rafagenova/arduino-equivalent-board/!Released Files/!!! IMPORTANT !!! Release Document for Altium Designer.txt

Follow this procedure before releasing files. Confirm every action with your initials and date.
IF ANY CHANGES NEEDS TO BE DONE, START THE PROCEDURE FROM BEGINNING!

The procedure needs to be executed in order as defined here. Start from number 1
--------------------------------------------------------------------------------

1) Right Click on the project -> Compile PCB project
I confirm, the project compiles with no errors: 
RF [12-NOV-2020]

2) Run Design -> Update PCB Document
I confirm, there are no differences between Schematic and PCB: 
RF [12-NOV-2020]

3) Impedance
I confirm, I have updated and check track width/gap to match required impedance (e.g 55 OHMs): 
NA

4) Run Tools -> Polygon Pours -> Rebuild All
I confirm, all polygons have been repoured: 
RF [12-NOV-2020]

5) Run Tools -> Design Rule Check -> Run Design Rule Check
I confirm, I have checked Design Rule Output File:
RF [12-NOV-2020]

6) Gerber check
I confirm, I have copied and visually checked gerber files placed in \PCB Manufacturing\Gerber Output\
RF [12-NOV-2020]

7) Other files
I confirm, I have copied and checked files placed in subdirectories:
RF [12-NOV-2020]
