rafagenova/arduino-equivalent-board/!Released Files/Step 2 - Board Assembly/Variant 1 - 28Pins V1I1 - 5V FIXED/BOM Purchasing - 28Pins V1I1 - FIXED 5V.xlsx

Sheet: Part List Report
 | Component list |  |  | 28Pins BOM Purchasing for Variant [FIXED 5V] of Project [28Pins_Project_V1I1.PrjPcb] (PCB Document : 28Pins_PCB.PcbDoc)
 | Source Data From: | 28Pins_Project_V1I1.PrjPcb |  |  | Contact: |  |  |  | Generated by:
 | Project: | 28Pins_Project_V1I1.PrjPcb
 | Variant: | FIXED 5V |  |  |  |  |  |  | FEDEVEL
 | Report Date: | 13/11/2020 | 12:58 |  |  |  |  |  | http://www.fedevel.com
 | Print Date: | 2020-11-13 | 12:58:43
# | Category | Manufacturer 1 | Manufacturer Part Number 1 | Case/Package | Description | Quantity | Supplier 1 | Supplier Part Number 1 | Supplier Order Qty 1 | Supplier Stock 1 | Supplier Unit Price 1 | Supplier Subtotal 1 | Supplier Currency 1
1 | Aluminum Electrolytic Capacitors | Panasonic | EEE-1AA101WR | Radial | Cap Aluminum 100uF 10V 20% (5 X 5.4mm) SMD 50mA 1000 hr 85°C T/R | 2 | TTI | EEE-1AA101WR | 2000 | 171000 | 0.06 | 110.00 | USD
2 | Ceramic Capacitors | TDK | C2012X5R1C106K085AC | 805 | TDK - C2012X5R1C106K085AC - SMD Multilayer Ceramic Capacitor, 10 µF, 16 V, 0805 [2012 Metric], ± 10%, X5R, C Series TDK | 7 | Digi-Key | 445-7644-1-ND | 7000 | 1270360 | 0.06 | 407.33 | USD
3 | Ceramic Capacitors | TDK | C2012X7R1H104K085AA | 805 | TDK - C2012X7R1H104K085AA - SMD Multilayer Ceramic Capacitor, 0.1 µF, 50 V, 0805 [2012 Metric], ± 10%, X7R, C Series | 19 | Digi-Key | 445-7534-1-ND | 19000 | 411549 | 0.03 | 538.27 | USD
4 | Ceramic Capacitors | TDK | C2012X5R1E105K125AA | 805 | TDK - C2012X5R1E105K125AA - SMD Multilayer Ceramic Capacitor, 1 µF, 25 V, 0805 [2012 Metric], ± 10%, X5R, C Series | 1 | Digi-Key | 445-1419-1-ND | 1000 | 1716 | 0.05 | 48.58 | USD
5 | Ceramic Capacitors | KEMET | C0805C180J5GACTU | 805 | CAP CER 18PF 50V C0G/NP0 0805 | 4 | Digi-Key | 399-1112-1-ND | 4000 | 86095 | 0.02 | 94.44 | USD
6 | Uncategorized | Osram Opto | LGL29K-F2J1-24-Z | 603 | LED Uni-Color Green 572nm Automotive 2-Pin Chip 0603(1608Metric) T/R | 1 | NAC Semi | LGL29K-F2J1-24-Z |  | 20000 |  |  | USD
7 | Uncategorized | Osram Opto | LOL29K-H2K1-24 | 1608 | LED Uni-Color Orange 610nm 2-Pin Case 0603 T/R | 3 | Mouser | 720-LOL29KH2K124Z | 3000 | 16953 | 0.11 | 339.00 | USD
8 | Schottky Diodes | ON Semiconductor / Fairchild | BAT54HT1G |  | Small Signal Schottky Diode, Single, 30 V, 200 mA, 800 mV, 600 mA, 150 C ;RoHS Compliant: Yes | 2 | Digi-Key | BAT54HT1GOSCT-ND | 2000 | 244230 | 0.04 | 82.80 | USD
9 | Ferrite Beads and Chips | TDK | MPZ2012S601AT000 | 805 | FERRITE BEAD 600 OHM 0805 1LN | 3 | Digi-Key | 445-2206-1-ND | 3000 | 197637 | 0.03 | 87.84 | USD
10 | Headers and Wire Housings | Harwin | M20-7820842 | SIL | 2.54mm (0.1") Pitch SIL Vertical PC Tail Socket Assembly, selective gold + tin, 8 contacts | 2 | Digi-Key | 952-1823-ND | 2000 | 859 | 0.65 | 1292.80 | USD
11 | Headers and Wire Housings | Harwin | M20-7820646 | SIL | 06-WAY SIL VERT SOCKET L/FREE | 1 | Digi-Key | 952-1809-ND | 1000 | 2084 | 0.56 | 558.40 | USD
12 | Headers and Wire Housings | Harwin | M20-7821046 | SIL | HARWIN - M20-7821046 - Board-To-Board Connector, M20 Series, Through Hole, Receptacle, 10, 2.54 mm, Tin Plated Contacts | 1 | Digi-Key | 952-1847-ND | 1000 | 0 | 0.63 | 625.60 | USD
13 | Headers and Wire Housings | Amphenol ICC / FCI | 67997-106HLF |  | CONN HEADER 6POS .100 STR 30AU | 2 | Digi-Key | 609-3393-ND | 2000 | 1303 | 0.99 | 1976.70 | USD
14 | USB Connectors | AMPHENOL ICC (FCI) | 10118193-0001LF |  | CONN USB MICRO B RECPT SMT R/A | 1 | Digi-Key | 609-4616-1-ND | 1000 | 0 | 0.26 | 257.88 | USD
15 | Headers and Wire Housings | Amphenol ICC | 68000-103HLF |  | Conn Unshrouded Header HDR 3 POS 2.54mm Solder ST Thru-Hole Bulk | 1 | Digi-Key | 609-3461-ND | 1000 | 5274 | 0.14 | 139.30 | USD
16 | Headers and Wire Housings | Amphenol FCI | 68001-204HLF |  | CONN HEADER VERT 4POS 2.54MM | 1 | Digi-Key | 609-3402-ND | 1000 | 2472 | 0.18 | 178.68 | USD
17 | Fixed Inductors | KEMET | L1210R2R2MDWIT | 1210 | FIXED IND 2.2UH 2A 80 MOHM SMD | 1 | TTI | L1210R2R2MDWIT | 1000 | 14000 | 0.18 | 183.00 | USD
18 | Connectors | Sullins | QPC02SXGN-RC | 100 | CONN JUMPER SHORTING .100" GOLD | 2 | Digi-Key | S9337-ND | 2000 | 1052956 | 0.03 | 52.92 | USD
19 | Chip SMD Resistors | Yageo | RC0805FR-07100KL | 805 | YAGEO RC0805FR-07100KL RES, THICK FILM, 100K, 1%, 0.125W, 0805, REEL | 1 | Digi-Key | 311-100KCRCT-ND | 1000 | 2714272 | 0.01 | 6.65 | USD
20 | Chip SMD Resistors | Yageo | RC0805FR-07560RL | 805 | Surface Mount Thick Film Resistor, RC Series, 560 ohm, 125 mW, - 1%, 150 V, 0805 [2012 Metric] | 5 | Digi-Key | 311-560CRCT-ND | 5000 | 0 | 0.01 | 28.85 | USD
21 | Chip SMD Resistors | Yageo | RC0805FR-0710KL | 805 | RES SMD 10K OHM 1% 1/8W 0805 | 6 | Digi-Key | 311-10.0KCRCT-ND | 6000 | 16724231 | 0.01 | 34.62 | USD
22 | Chip SMD Resistors | Yageo | RC0805FR-0722RL | 805 | RES SMD 22 OHM 1% 1/8W 0805 | 7 | Digi-Key | 311-22.0CRCT-ND | 7000 | 588085 | 0.01 | 40.39 | USD
23 | Chip SMD Resistors | Yageo | RC0805JR-070RL | 805 | Surface Mount Thick Film Resistor, RC Series, 125 mW, - 5%, 150 V, 0805 [2012 Metric] | 2 | Digi-Key | 311-0.0ARCT-ND | 2000 | 5204056 | 0.01 | 11.44 | USD
24 | Chip SMD Resistors | Yageo | RC0805FR-071ML | 805 | RES SMD 1M OHM 1% 1/8W 0805 | 2 | Digi-Key | 311-1.00MCRCT-ND | 2000 | 2559440 | 0.01 | 13.30 | USD
25 | Chip SMD Resistors | Yageo | RC0805FR-071KL | 805 | RESISTOR, 0805 1K 1%, FULL REEL; Product Range:YAGEO - RC Series; Resistance:1kohm; Power Rating:125mW; Resistance Tolerance:± 1%; Resistor Case Style:0805 [2012 Metric]; Resistor Element Material:Thick Film; Temperature Coefficient:± 250ppm/°C; Voltage Rating:150V; Packaging:Tape & Reel; MSL:-; SVHC:No SVHC (16-Dec-2013); External Depth:0.55mm; External Length / Height:2mm; External Width:1.25mm; No. of Pins:2; Operating Temperature Max:155°C; Operating Temperature Min:-55°C; Operating Temperature Range:-55°C to +155°C; Reel Quantity:5000; Resistor Mounting:SMD; Series:RC12H; Temperature Coef | 3 | Digi-Key | 311-1.00KCRCT-ND | 3000 | 15540939 | 0.01 | 17.31 | USD
26 | Connectors | 3M | 7010501790 |  | CONN IC DIP SOCKET 28POS TIN | 1 | Digi-Key | 3M5480-ND | 1000 | 3382 | 0.44 | 435.04 | USD
27 | Pushbutton Switches | TE Connectivity | FSM4JH |  | SWITCH TACTILE SPST-NO 0.05A 24V | 2 | Digi-Key | 450-1650-ND | 2000 | 97566 | 0.06 | 125.30 | USD
28 | Microcontrollers | Microchip / Atmel | ATMEGA328P-PU | PDIP | ATMEGA328P-PU; 8 bit Microcontroller AVR 20MHz 1; 32kb Flash; 2kb RAM; I2C SPI 2 | 1 | Digi-Key | ATMEGA328P-PU-ND | 1000 | 6893 | 1.73 | 1730.00 | USD
29 | Microcontrollers | Microchip | ATMEGA16U2-AU | A | MICROCHIP - ATMEGA16U2-AU - MCU, 8BIT, MEGAAVR, 16MHZ, TQFP-32 | 1 | Digi-Key | ATMEGA16U2-AU-ND | 1000 | 3181 | 2.04 | 2040.00 | USD
30 | Voltage Regulators - Linear | Texas Instruments | TL1963A-33DCQR | SOT-223 | IC REG LINEAR 3.3V 1.5A SOT223-6 | 1 | Digi-Key | 296-24534-1-ND | 1000 | 2622 | 1.40 | 1404.48 | USD
31 | Logic Gates | Texas Instruments | SN74AHC1G09DBVR | SOT-23 | TEXAS INSTRUMENTS - SN74AHC1G09DBVR - AND Gate, 74AHC1G09, 2 Input, 2 V to 5.5 V, SOT-23-5 | 4 | Digi-Key | 296-29202-1-ND | 4000 | 20291 | 0.07 | 276.00 | USD
32 | Crystals | Abracon | ABM7-16.000MHZ-D2Y-T | CSMD | CRYSTAL 16.0000MHZ 18PF SMD | 2 | Digi-Key | 535-9840-1-ND | 2000 | 57628 | 0.60 | 1209.60 | USD
33 | Varistors | Bourns | CG0603MLC-05E | 603 | VARISTOR 0603 | 2 | Digi-Key | CG0603MLC-05ECT-ND | 2000 | 91563 | 0.10 | 208.00 | USD
 |  |  |  |  |  | 94 |  |  | 93000 |  |  | 14554.52
Approved |  |  |  | Notes
 |  |  |  |  |  | 1000 | pcs: | Total |  | 14554.52 |  | USD
 |  |  |  |  |  |  |  | Price for 1pcs |  | 14.55 |  | USD

Sheet: Project Information
Project Full Path | C:\Users\rafae\OneDrive\Área de Trabalho\Férias 2020\PCB Design\Design Files\V1I1\28Pins_Project_V1I1\28Pins_Project_V1I1.PrjPcb
Project Filename | 28Pins_Project_V1I1.PrjPcb
Variant Name | FIXED 5V
Data-Source Filename | 28Pins_Project_V1I1.PrjPcb
Data-Source Full Path | C:\Users\rafae\OneDrive\Área de Trabalho\Férias 2020\PCB Design\Design Files\V1I1\28Pins_Project_V1I1\28Pins_Project_V1I1.PrjPcb
Title | 28Pins BOM Purchasing for Variant [FIXED 5V] of Project [28Pins_Project_V1I1.PrjPcb] (PCB Document : 28Pins_PCB.PcbDoc)
Total Quantity | 94
Report Time | 12:58
Report Date | 13/11/2020
Report Date & Tine | 13/11/2020 12:58
Output Name | 28Pins BOM Purchasing
Output Type | BOM_PartType
Output Generator Name | BOM
Output Generator Description | Bill of Materials
