rafagenova/arduino-equivalent-board/!Released Files/Step 2 - Board Assembly/Variant 1 - 28Pins V1I1 - 5V FIXED/BOM Reference - 28Pins V1I1 - FIXED 5V.xlsx

Sheet: Part List Report
 | Component reference list |  |  | 28Pins
 |  | Source Data From: | 28Pins_Project_V1I1.PrjPcb |  | Contact: |  | Generated by:
 |  | Project: | 28Pins_Project_V1I1.PrjPcb
 |  | Variant: | FIXED 5V |  |  |  | FEDEVEL
 | Report Date: | 13/11/2020 | 14:43 |  |  |  | http://www.fedevel.com
 | Print Date: | 2020-11-13 | 14:43:36
# | Designator | Comment | Description | Manufacturer 1 | Manufacturer Part Number 1 | Case/Package | Supplier 1 | Supplier Part Number 1
1 | R1 | 100k | YAGEO RC0805FR-07100KL RES, THICK FILM, 100K, 1%, 0.125W, 0805, REEL | Yageo | RC0805FR-07100KL | 805 | Digi-Key | 311-100KCRCT-ND
2 | R2, R3, R15, R17, R22 | 560R | Surface Mount Thick Film Resistor, RC Series, 560 ohm, 125 mW, - 1%, 150 V, 0805 [2012 Metric] | Yageo | RC0805FR-07560RL | 805 | Digi-Key | 311-560CRCT-ND
3 | R4, R14, R18, R19, R20, R21 | 10k | RES SMD 10K OHM 1% 1/8W 0805 | Yageo | RC0805FR-0710KL | 805 | Digi-Key | 311-10.0KCRCT-ND
4 | R5, R6, R7, R13, R23, R24, R25 | 22R | RES SMD 22 OHM 1% 1/8W 0805 | Yageo | RC0805FR-0722RL | 805 | Digi-Key | 311-22.0CRCT-ND
5 | R8, R27 | 0R | Surface Mount Thick Film Resistor, RC Series, 125 mW, - 5%, 150 V, 0805 [2012 Metric] | Yageo | RC0805JR-070RL | 805 | Digi-Key | 311-0.0ARCT-ND
6 | R9, R16 | 1M | RES SMD 1M OHM 1% 1/8W 0805 | Yageo | RC0805FR-071ML | 805 | Digi-Key | 311-1.00MCRCT-ND
7 | R10, R11, R12 | 1k | RESISTOR, 0805 1K 1%, FULL REEL; Product Range:YAGEO - RC Series; Resistance:1kohm; Power Rating:125mW; Resistance Tolerance:± 1%; Resistor Case Style:0805 [2012 Metric]; Resistor Element Material:Thick Film; Temperature Coefficient:± 250ppm/°C; Voltage Rating:150V; Packaging:Tape & Reel; MSL:-; SVHC:No SVHC (16-Dec-2013); External Depth:0.55mm; External Length / Height:2mm; External Width:1.25mm; No. of Pins:2; Operating Temperature Max:155°C; Operating Temperature Min:-55°C; Operating Temperature Range:-55°C to +155°C; Reel Quantity:5000; Resistor Mounting:SMD; Series:RC12H; Temperature Coef | Yageo | RC0805FR-071KL | 805 | Digi-Key | 311-1.00KCRCT-ND
8 | U3 | TL1963A-33DCQR | IC REG LINEAR 3.3V 1.5A SOT223-6 | Texas Instruments | TL1963A-33DCQR | SOT-223 | Digi-Key | 296-24534-1-ND
9 | U4, U5, U6, U7 | SN74AHC1G09DBVR | TEXAS INSTRUMENTS - SN74AHC1G09DBVR - AND Gate, 74AHC1G09, 2 Input, 2 V to 5.5 V, SOT-23-5 | Texas Instruments | SN74AHC1G09DBVR | SOT-23 | Digi-Key | 296-29202-1-ND
10 | SW1, SW2 | 1825910-6 | SWITCH TACTILE SPST-NO 0.05A 24V | TE Connectivity | FSM4JH |  | Digi-Key | 450-1650-ND
11 | C3, C12, C13, C19, C21, C22, C34 | 10u / 16V | TDK - C2012X5R1C106K085AC - SMD Multilayer Ceramic Capacitor, 10 µF, 16 V, 0805 [2012 Metric], ± 10%, X5R, C Series TDK | TDK | C2012X5R1C106K085AC | 805 | Digi-Key | 445-7644-1-ND
12 | C4, C5, C6, C8, C11, C14, C15, C16, C17, C20, C23, C24, C26, C28, C29, C30, C31, C32, C33 | 100n | TDK - C2012X7R1H104K085AA - SMD Multilayer Ceramic Capacitor, 0.1 µF, 50 V, 0805 [2012 Metric], ± 10%, X7R, C Series | TDK | C2012X7R1H104K085AA | 805 | Digi-Key | 445-7534-1-ND
13 | C7 | 1uF / 25V | TDK - C2012X5R1E105K125AA - SMD Multilayer Ceramic Capacitor, 1 µF, 25 V, 0805 [2012 Metric], ± 10%, X5R, C Series | TDK | C2012X5R1E105K125AA | 805 | Digi-Key | 445-1419-1-ND
14 | FB1, FB2, FB3 | MPZ2012S601AT000 | FERRITE BEAD 600 OHM 0805 1LN | TDK | MPZ2012S601AT000 | 805 | Digi-Key | 445-2206-1-ND
15 | LINK1, LINK2 | LINK | CONN JUMPER SHORTING .100" GOLD | Sullins | QPC02SXGN-RC | 100 | Digi-Key | S9337-ND
16 | C1, C2 | 100u / 10V | Cap Aluminum 100uF 10V 20% (5 X 5.4mm) SMD 50mA 1000 hr 85°C T/R | Panasonic | EEE-1AA101WR | Radial | TTI | EEE-1AA101WR
17 | D1 | Green | LED Uni-Color Green 572nm Automotive 2-Pin Chip 0603(1608Metric) T/R | Osram Opto | LGL29K-F2J1-24-Z | 603 | NAC Semi | LGL29K-F2J1-24-Z
18 | D2, D3, D4 | Orange | LED Uni-Color Orange 610nm 2-Pin Case 0603 T/R | Osram Opto | LOL29K-H2K1-24 | 1608 | Mouser | 720-LOL29KH2K124Z
19 | D5, D6 | BAT54HT1G | Small Signal Schottky Diode, Single, 30 V, 200 mA, 800 mV, 600 mA, 150 C ;RoHS Compliant: Yes | ON Semiconductor / Fairchild | BAT54HT1G |  | Digi-Key | BAT54HT1GOSCT-ND
20 | U1 | ATMEGA328P-PU | ATMEGA328P-PU; 8 bit Microcontroller AVR 20MHz 1; 32kb Flash; 2kb RAM; I2C SPI 2 | Microchip / Atmel | ATMEGA328P-PU | PDIP | Digi-Key | ATMEGA328P-PU-ND
21 | U2 | ATMEGA16U2-AU | MICROCHIP - ATMEGA16U2-AU - MCU, 8BIT, MEGAAVR, 16MHZ, TQFP-32 | Microchip / Atmel | ATMEGA16U2-AU | A | Digi-Key | ATMEGA16U2-AU-ND
22 | C9, C10, C25, C27 | 18p | CAP CER 18PF 50V C0G/NP0 0805 | KEMET | C0805C180J5GACTU | 805 | Digi-Key | 399-1112-1-ND
23 | L1 | 2u2 / 2A | FIXED IND 2.2UH 2A 80 MOHM SMD | KEMET | L1210R2R2MDWIT | 1210 | TTI | L1210R2R2MDWIT
24 | J1, J3 | HDR FEMALE 1x8 2.54mm | 2.54mm (0.1") Pitch SIL Vertical PC Tail Socket Assembly, selective gold + tin, 8 contacts | Harwin | M20-7820842 | SIL | Digi-Key | 952-1823-ND
25 | J2 | HDR FEMALE 1x6 2.54mm | 06-WAY SIL VERT SOCKET L/FREE | Harwin | M20-7820646 | SIL | Digi-Key | 952-1809-ND
26 | J4 | HDR FEMALE 1x10 2.54mm | HARWIN - M20-7821046 - Board-To-Board Connector, M20 Series, Through Hole, Receptacle, 10, 2.54 mm, Tin Plated Contacts | Harwin | M20-7821046 | SIL | Digi-Key | 952-1847-ND
27 | Z1, Z2 | CG0603MLC-05E | VARISTOR 0603 | Bourns | CG0603MLC-05E | 603 | Digi-Key | CG0603MLC-05ECT-ND
28 | J5, J6 | HDR 2x3 | CONN HEADER 6POS .100 STR 30AU | Amphenol ICC / FCI | 67997-106HLF |  | Digi-Key | 609-3393-ND
29 | J7 | 10118193-0001LF | CONN USB MICRO B RECPT SMT R/A | AMPHENOL ICC (FCI) | 10118193-0001LF |  | Digi-Key | 609-4616-1-ND
30 | JP1 | HDR 1x3 | Conn Unshrouded Header HDR 3 POS 2.54mm Solder ST Thru-Hole Bulk | Amphenol ICC | 68000-103HLF |  | Digi-Key | 609-3461-ND
31 | JP3 | HDR 1x4 | CONN HEADER VERT 4POS 2.54MM | Amphenol FCI | 68001-204HLF |  | Digi-Key | 609-3402-ND
32 | Y1, Y2 | ABM7-16.000MHZ-D2Y-T | CRYSTAL 16.0000MHZ 18PF SMD | Abracon | ABM7-16.000MHZ-D2Y-T | CSMD | Digi-Key | 535-9840-1-ND
33 | SCKT FOR U1 | 28-DIP Socket | CONN IC DIP SOCKET 28POS TIN | 3M | 7010501790 |  | Digi-Key | 3M5480-ND
Approved |  |  |  | Notes

Sheet: Project Information
Project Full Path | C:\Users\rafae\OneDrive\Área de Trabalho\Férias 2020\PCB Design\Design Files\V1I1\28Pins_Project_V1I1\28Pins_Project_V1I1.PrjPcb
Project Filename | 28Pins_Project_V1I1.PrjPcb
Variant Name | FIXED 5V
Data-Source Filename | 28Pins_Project_V1I1.PrjPcb
Data-Source Full Path | C:\Users\rafae\OneDrive\Área de Trabalho\Férias 2020\PCB Design\Design Files\V1I1\28Pins_Project_V1I1\28Pins_Project_V1I1.PrjPcb
Title | 28Pins_Project_V1I1.PrjPcb
Total Quantity | 94
Report Time | 14:43
Report Date | 13/11/2020
Report Date & Tine | 13/11/2020 14:43
Output Name | 28Pins Component reference BOM
Output Type | BOM_PartType
Output Generator Name | BOM
Output Generator Description | Bill of Materials
