rafagenova/arduino-equivalent-board/Design Files/V1I1/28Pins_Project_V1I1/BOM Purchase FEDEVEL Live.xlsx

Sheet: Part List Report
 | Component list |  |  | Field=Title
 | Source Data From: | Field=DataSourceFileName |  |  | Contact: |  |  |  | Generated by:
 | Project: | Field=ProjectFileName
 | Variant: | Field=VariantName |  |  |  |  |  |  | FEDEVEL
 | Report Date: | Field=ReportDate | Field=ReportTime |  |  |  |  |  | http://www.fedevel.com
 | Print Date: | 2020-09-30 | 20:50:32
# | Column=Category | Column=Manufacturer 1 | Column=Manufacturer Part Number 1 | Column=Case/Package | Column=Description | Column=Quantity | Column=Supplier 1 | Column=Supplier Part Number 1 | Column=Supplier Order Qty 1 | Column=Supplier Stock 1 | Column=Supplier Unit Price 1 | Column=Supplier Subtotal 1 | Column=Supplier Currency 1
1
2
3
 |  |  |  |  |  | 0 |  |  | 0 |  |  | 0
Approved |  |  |  | Notes
 |  |  |  |  |  | Field=ProductionQuantity | pcs: | Total |  | 0 |  | Field=Currency
 |  |  |  |  |  |  |  | Price for 1pcs |  | #VALUE! |  | Field=Currency

Sheet: Project Information
Project Full Path | Field=ProjectFullPath
Project Filename | Field=ProjectFileName
Variant Name | Field=VariantName
Data-Source Filename | Field=DataSourceFileName
Data-Source Full Path | Field=DataSourceFullPath
Title | Field=Title
Total Quantity | Field=TotalQuantity
Report Time | Field=ReportTime
Report Date | Field=ReportDate
Report Date & Tine | Field=ReportDateTime
Output Name | Field=OutputName
Output Type | Field=OutputType
Output Generator Name | Field=GeneratorName
Output Generator Description | Field=GeneratorDescription
