rafagenova/arduino-equivalent-board/3d/HDR_1x3_White.stp

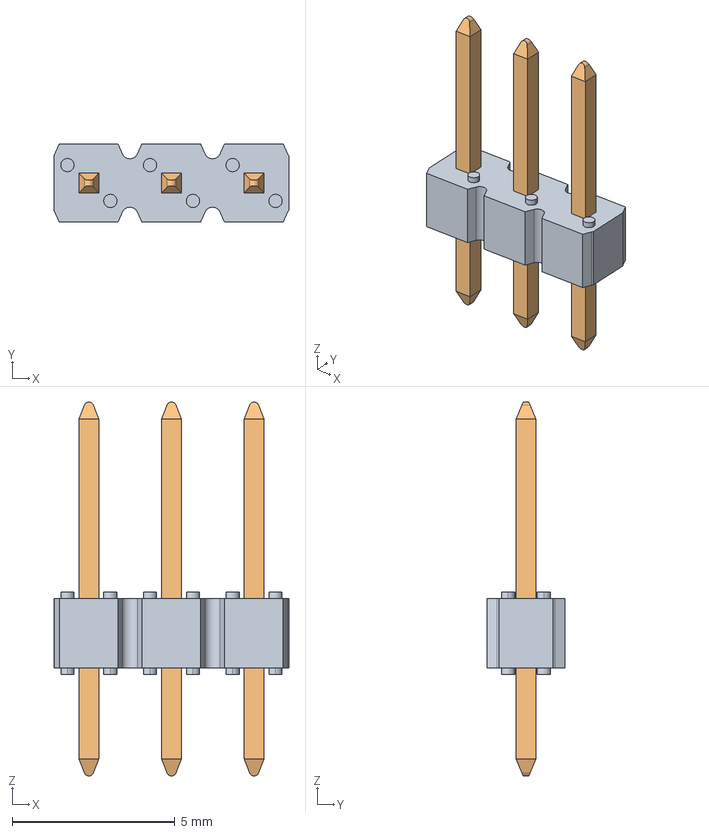
[picture p1: CAD file, 2022-08-11]
3d/HDR_1x3_White.stp
7.22 x 2.41 x 11.5 mm
77310_Y16 x 3
