rafagenova/arduino-equivalent-board/3d/User Library-LED SMD 0603 super red.step

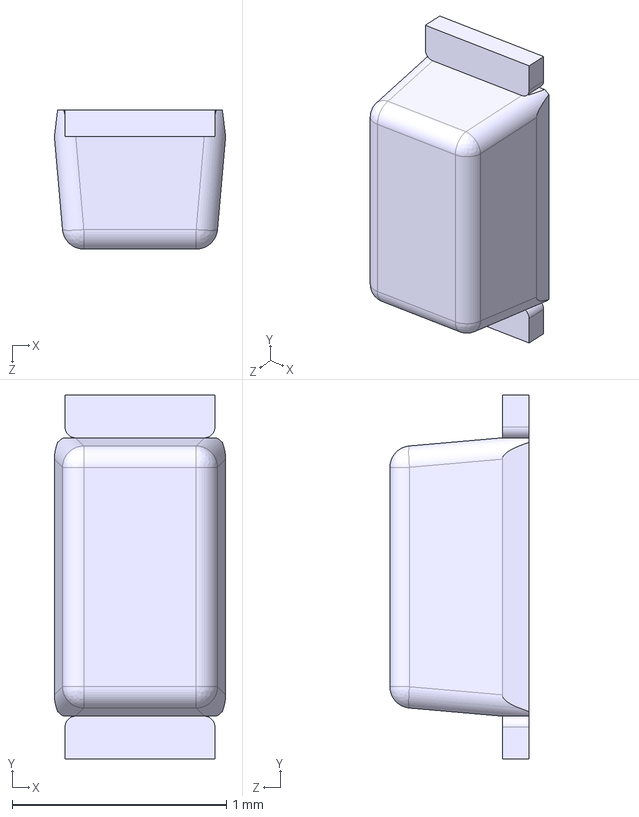
[picture p2: CAD file, 2022-08-11]
3d/User Library-LED SMD 0603 super red.step
0.8 x 1.70 x 0.65 mm
