rafagenova/arduino-equivalent-board/3d/User Library-TPS79333DBVR.step

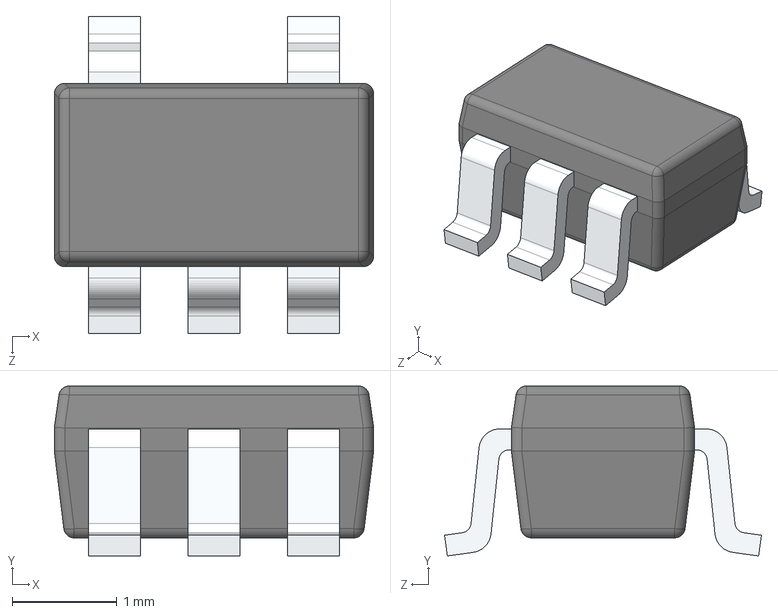
[picture p3: CAD file, 2022-08-11]
3d/User Library-TPS79333DBVR.step
3.05 x 1.62 x 3.03 mm
