rafagenova/arduino-equivalent-board/3d/User Library-28 pin dip.step

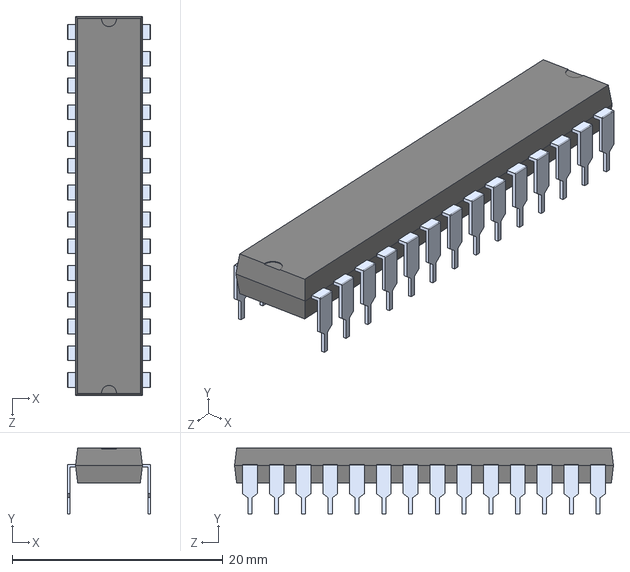
[picture p4: CAD file, 2022-08-11]
3d/User Library-28 pin dip.step
7.87 x 6.22 x 35.9 mm
