rafagenova/arduino-equivalent-board/3d/ABM7.STEP

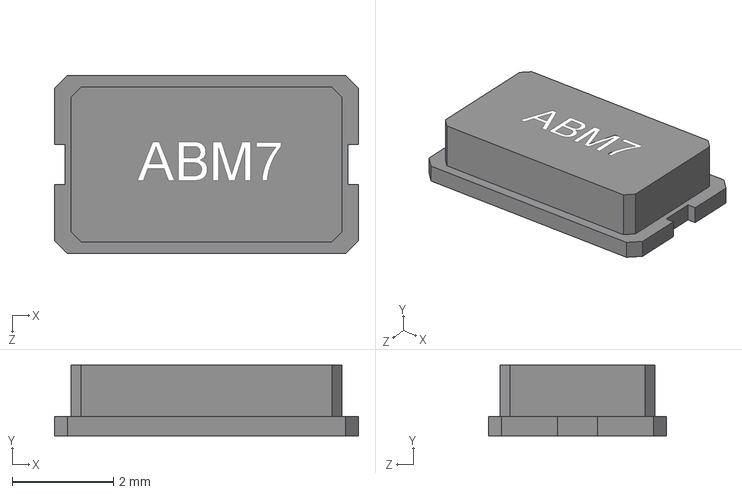
[picture p5: CAD file, 2022-08-11]
3d/ABM7.STEP
5.99 x 1.40 x 3.51 mm
