rafagenova/arduino-equivalent-board/3d/RESC2012X70N EIA 0805.step

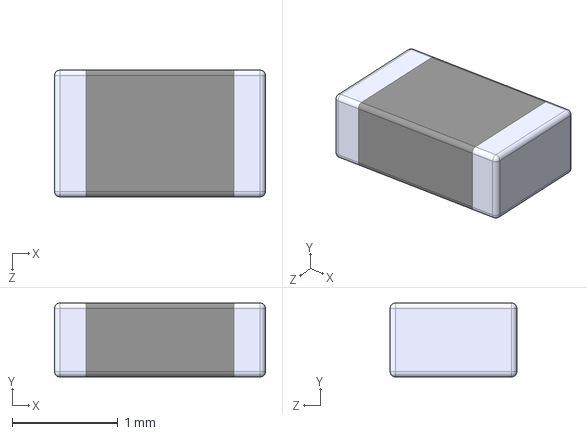
[picture p6: CAD file, 2022-08-11]
3d/RESC2012X70N EIA 0805.step
2.00 x 0.7 x 1.20 mm
