rafagenova/arduino-equivalent-board/3d/User Library-FSM4JLH(1825910-5).step

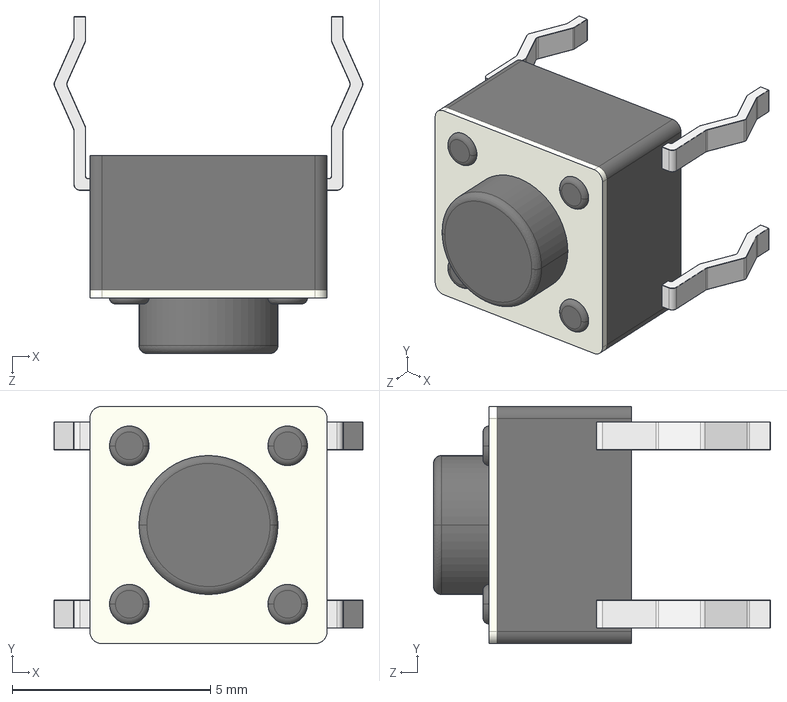
[picture p7: CAD file, 2022-08-11]
3d/User Library-FSM4JLH(1825910-5).step
7.80 x 5.99 x 8.51 mm
