rafagenova/arduino-equivalent-board/3d/User Library-TPS73701DCQ.step

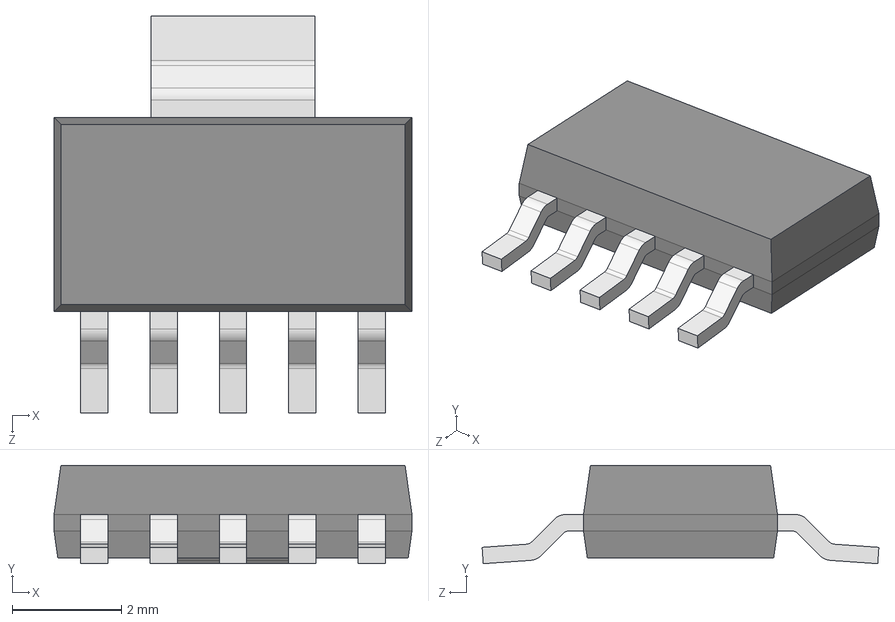
[picture p8: CAD file, 2022-08-11]
3d/User Library-TPS73701DCQ.step
6.55 x 1.80 x 7.26 mm
