rafagenova/arduino-equivalent-board/3d/User Library-SOD323.step

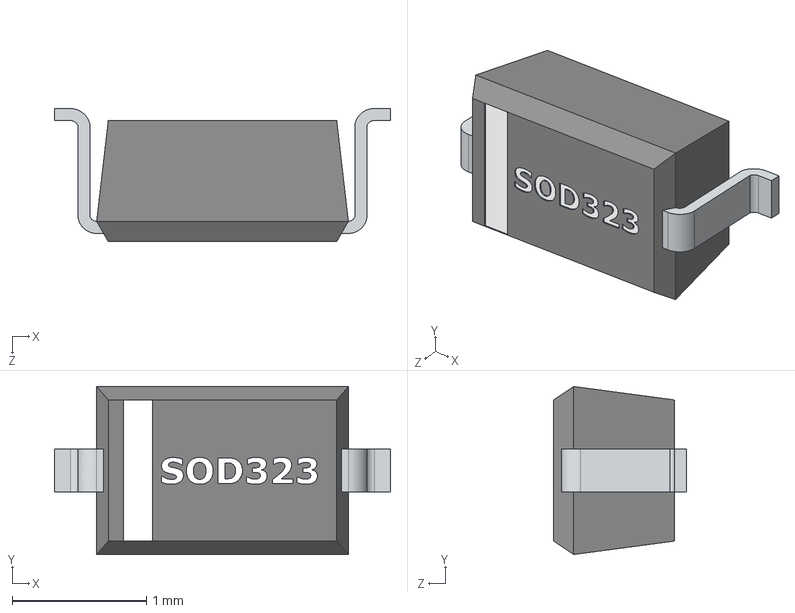
[picture p9: CAD file, 2022-08-11]
3d/User Library-SOD323.step
2.50 x 1.25 x 0.99 mm
