rafagenova/arduino-equivalent-board/3d/User Library-TQFP32-1.step

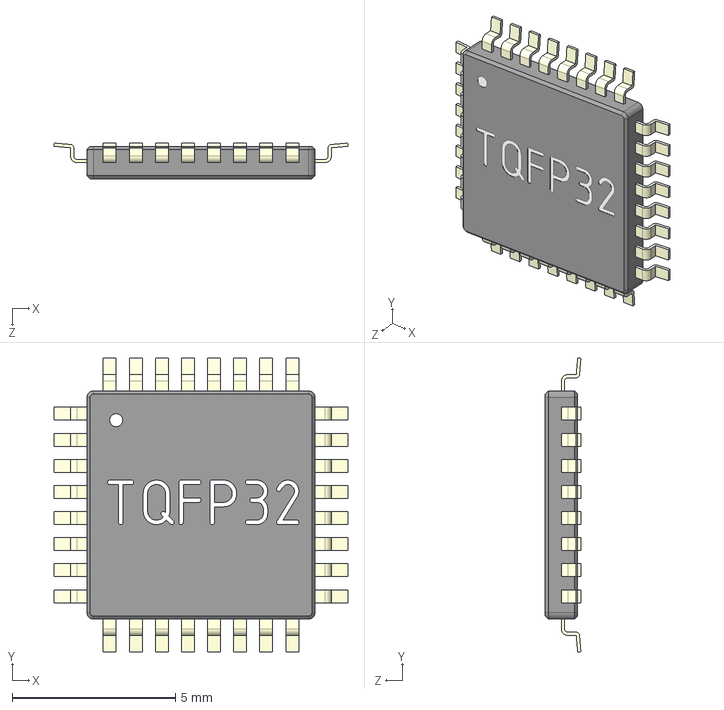
[picture p10: CAD file, 2022-08-11]
3d/User Library-TQFP32-1.step
9.02 x 9.02 x 1.10 mm
