rafagenova/arduino-equivalent-board/3d/HDR_1x4_White.stp

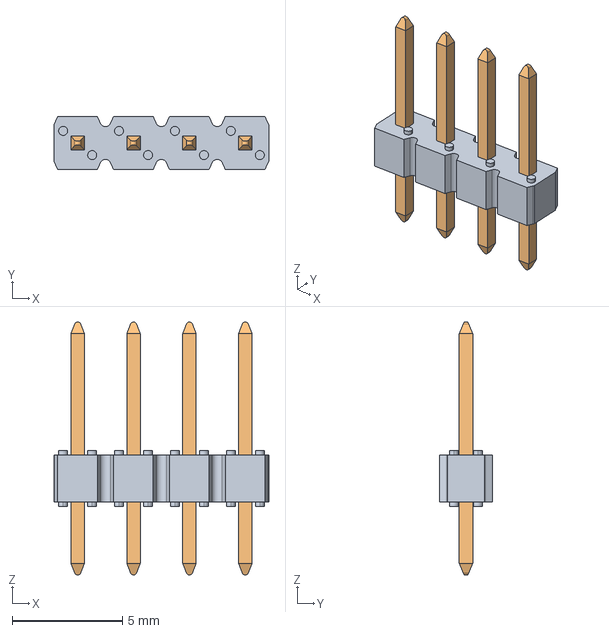
[picture p11: CAD file, 2022-08-11]
3d/HDR_1x4_White.stp
9.76 x 2.41 x 11.5 mm
