rafagenova/arduino-equivalent-board/3d/dil_socket.stp

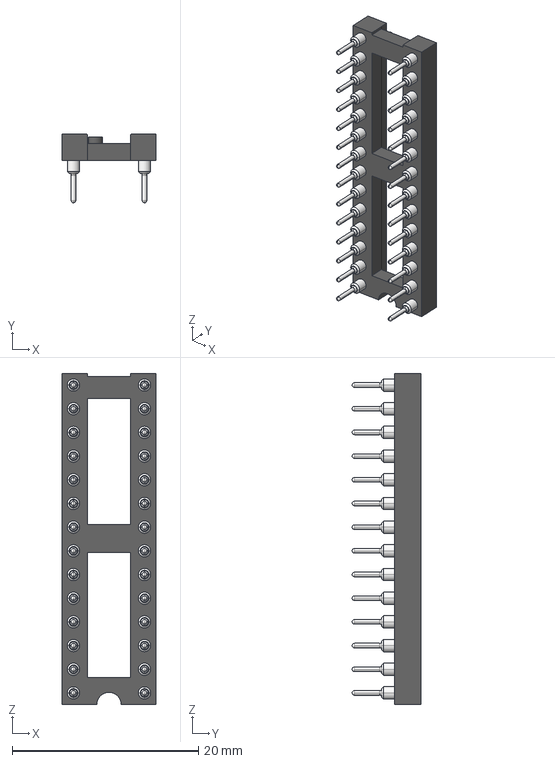
[picture p12: CAD file, 2022-08-11]
3d/dil_socket.stp
10.1 x 7.37 x 35.5 mm
