rafagenova/arduino-equivalent-board/3d/User Library-capacitor size C.step

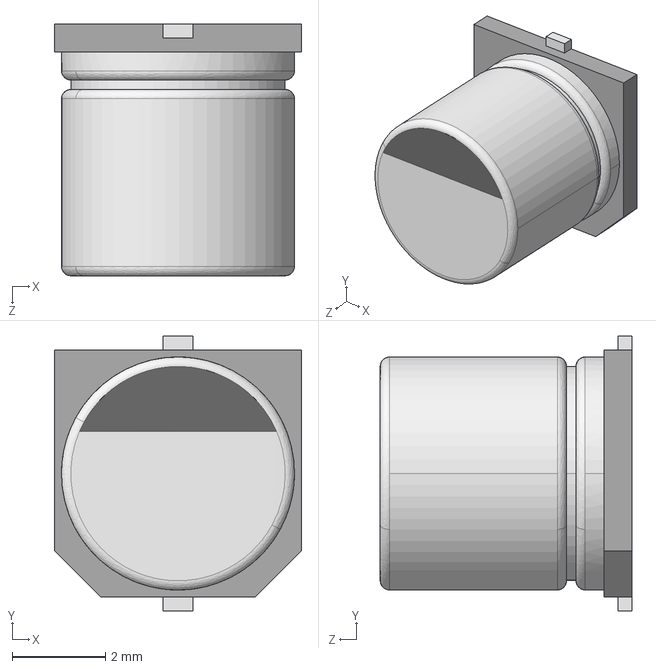
[picture p13: CAD file, 2022-08-11]
3d/User Library-capacitor size C.step
5.30 x 5.90 x 5.41 mm
