rafagenova/arduino-equivalent-board/3d/CAPC2012X95N EIA 0805.step

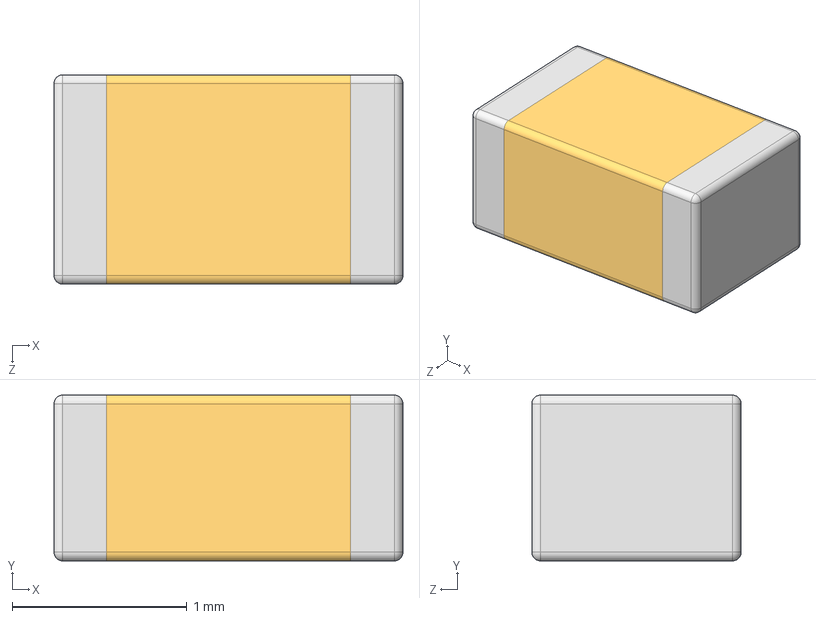
[picture p14: CAD file, 2022-08-11]
3d/CAPC2012X95N EIA 0805.step
2.00 x 0.95 x 1.20 mm
