rafagenova/arduino-equivalent-board/3d/R0603.step

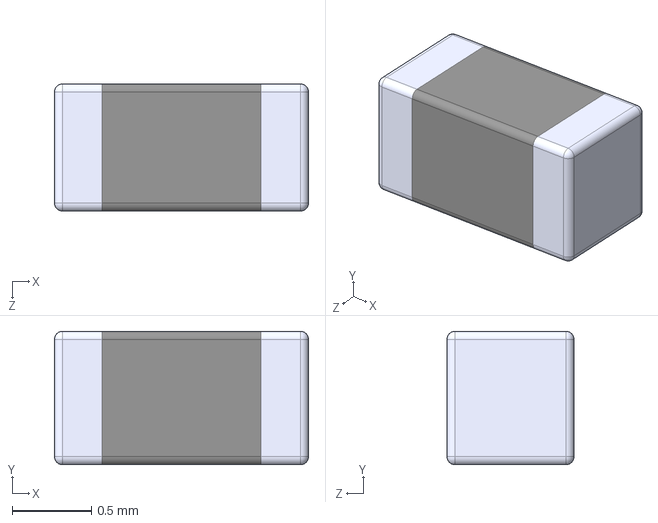
[picture p15: CAD file, 2022-08-11]
3d/R0603.step
1.60 x 0.84 x 0.8 mm
