rafagenova/arduino-equivalent-board/3d/m20-7820842_asm.stp

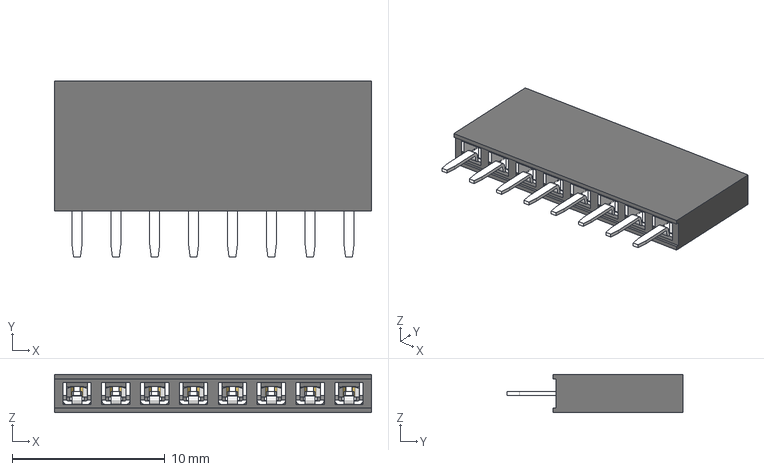
[picture p16: CAD file, 2022-08-11]
3d/m20-7820842_asm.stp
20.7 x 11.5 x 2.50 mm
M20-78208_MOULD
M20-782_CONTACT x 8
