rafagenova/arduino-equivalent-board/(list of files, cad)

Other CAD files:
3d/961204-6404-XX.stp
3d/961206-6404-XX.stp
