rafagenova/arduino-equivalent-board/!Released Files/Step 1 - PCB Manufacturing/NC Drill Output/28Pins Drill Drawing.PDF

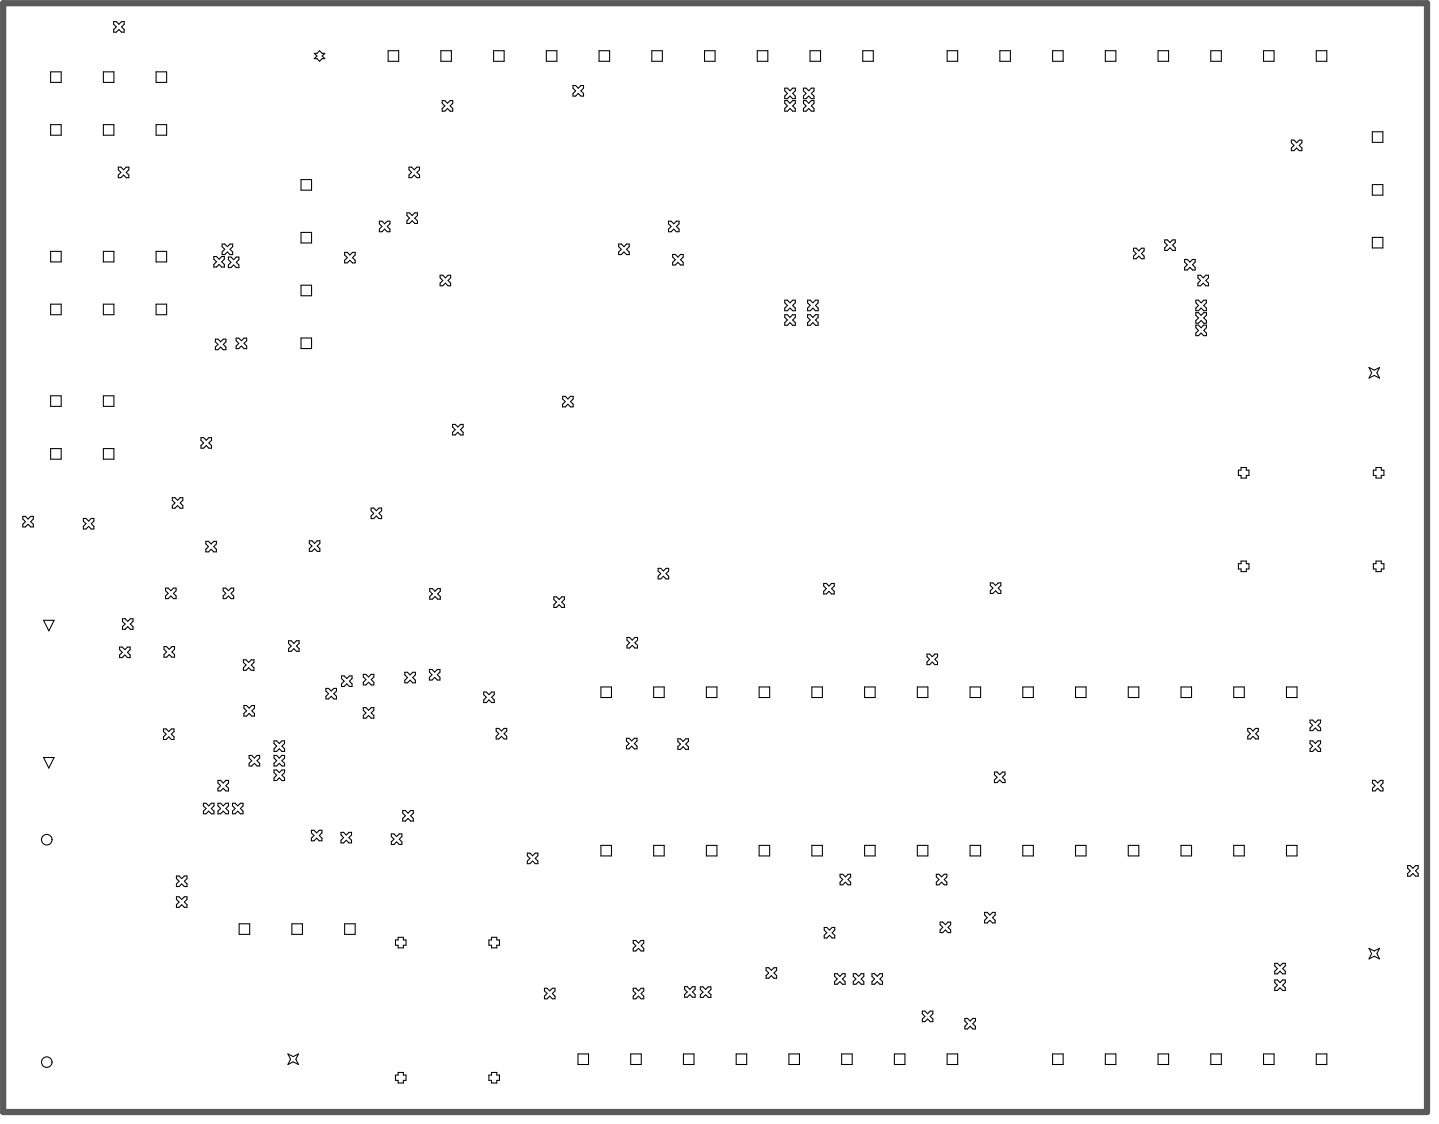
[picture p20: page 1]

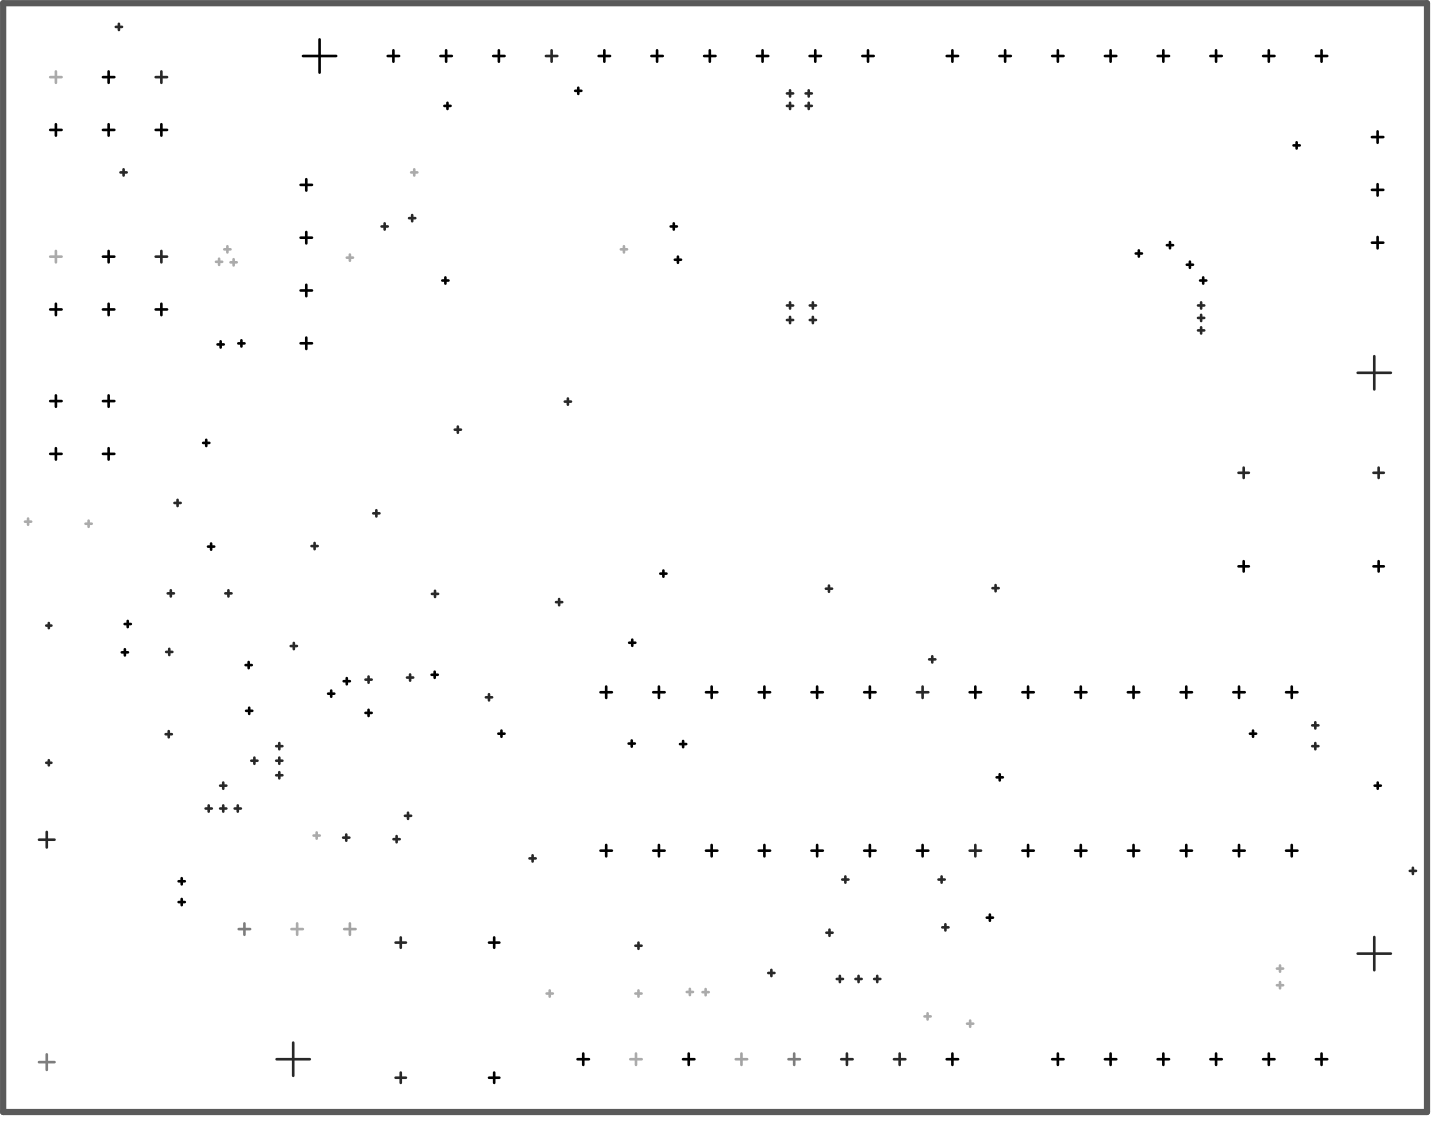
[picture p21: page 2]
