rafagenova/arduino-equivalent-board/!Released Files/Step 2 - Board Assembly/Variant 1 - 28Pins V1I1 - 5V FIXED/28Pins Assembly Drawing V1I1 - FIXED 5V.PDF

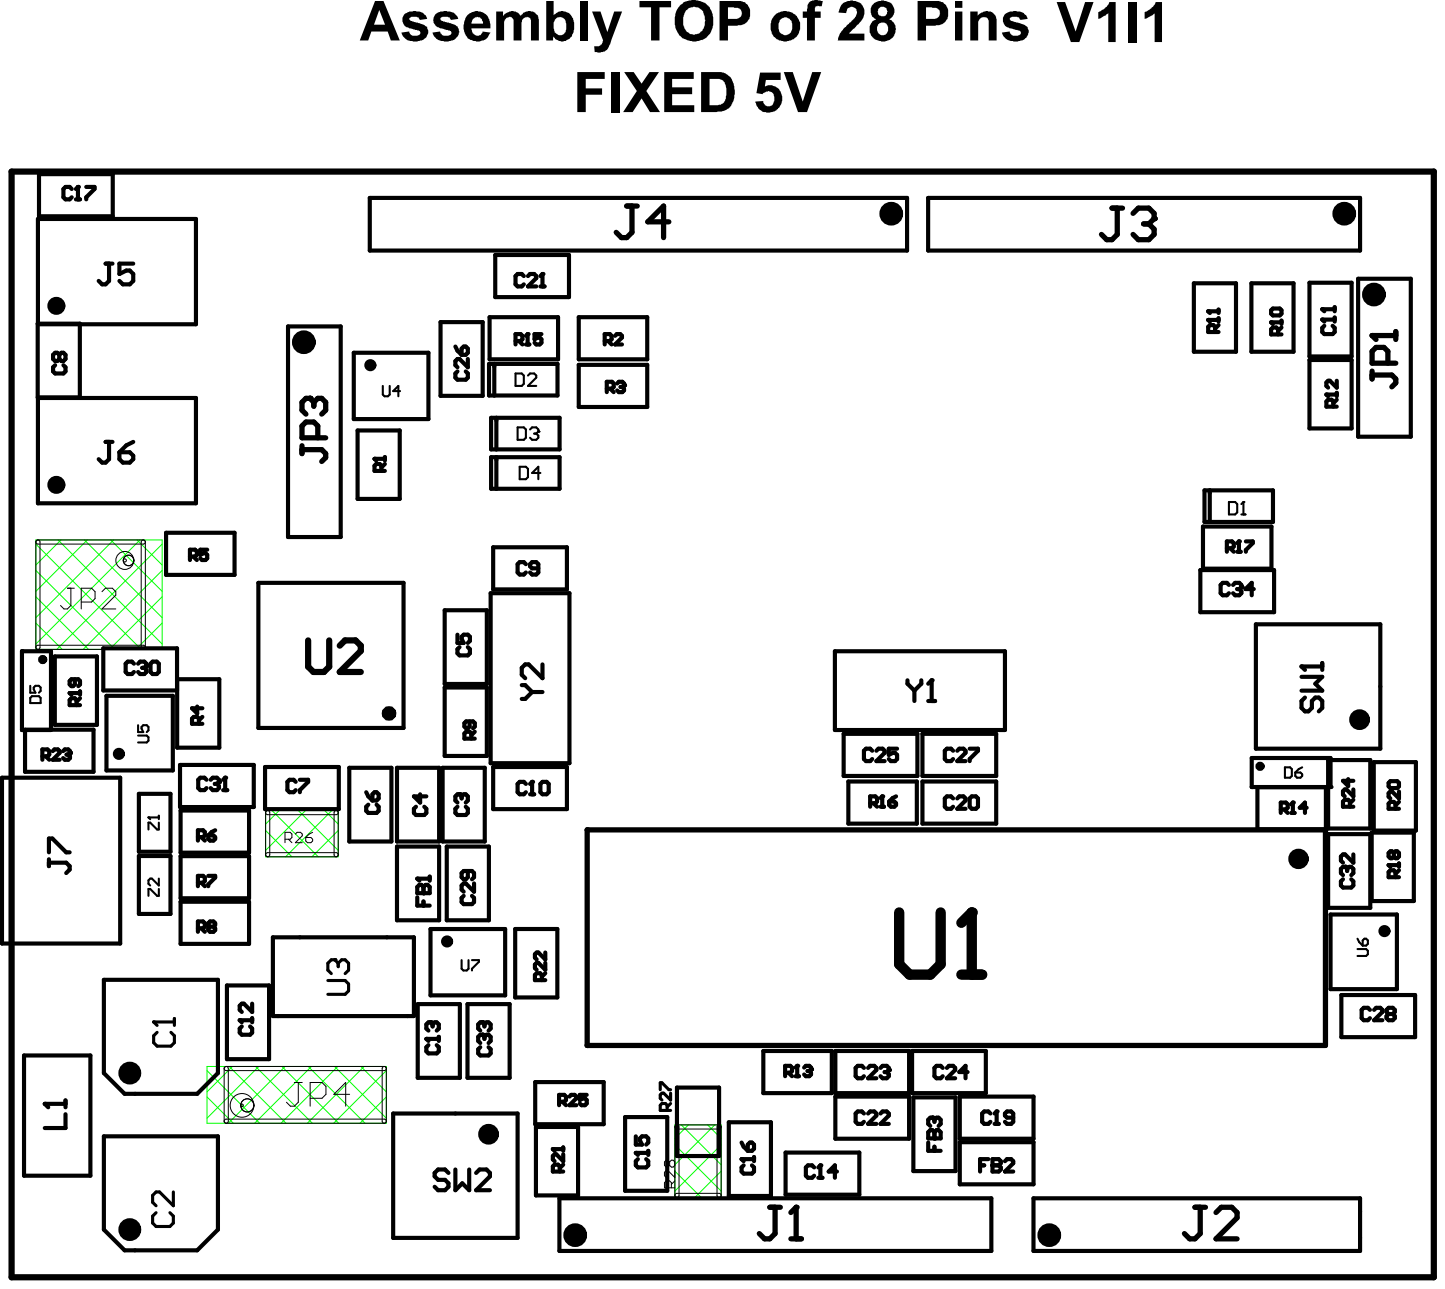
[picture p22: page 1]
