rafagenova/arduino-equivalent-board/!Released Files/Step 2 - Board Assembly/Variant 1 - 28Pins V1I1 - 5V FIXED/28Pins Mechanical Drawing.pdf

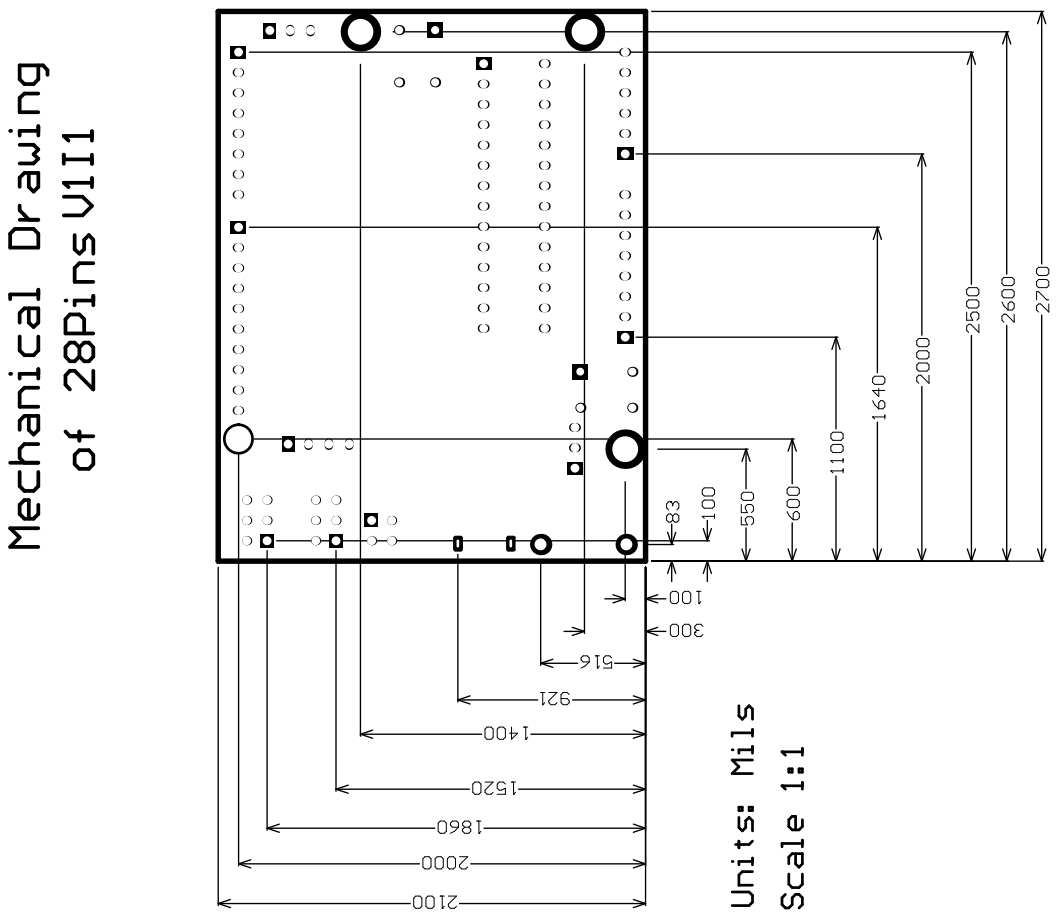
[picture p23: page 1]
