rafagenova/arduino-equivalent-board/!Released Files/Step 2 - Board Assembly/Variant 2 - 28Pins V1I1 - 3V3 AND 5V/28Pins Assembly Drawing V1I1 - 5V AND 3V3.PDF

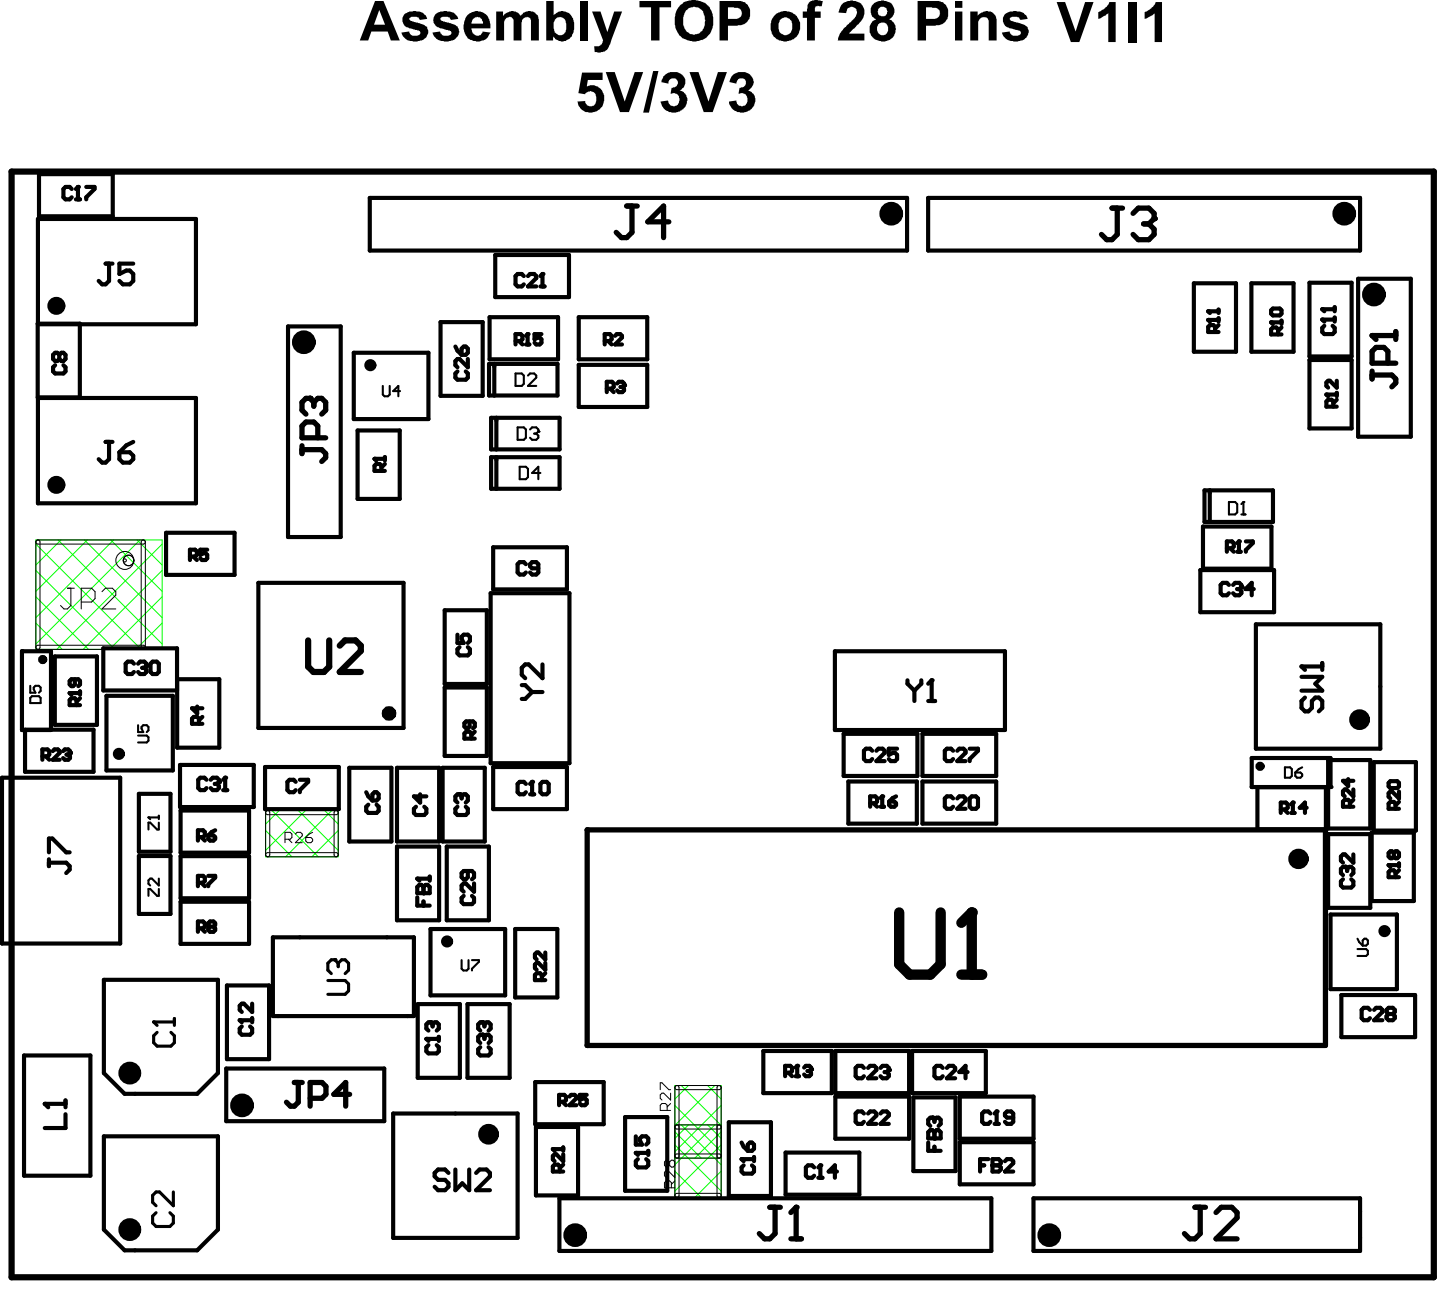
[picture p24: page 1]
