rafagenova/arduino-equivalent-board/Design Files/V1I1/28Pins_Project_V1I1/28Pins Library Check.pdf

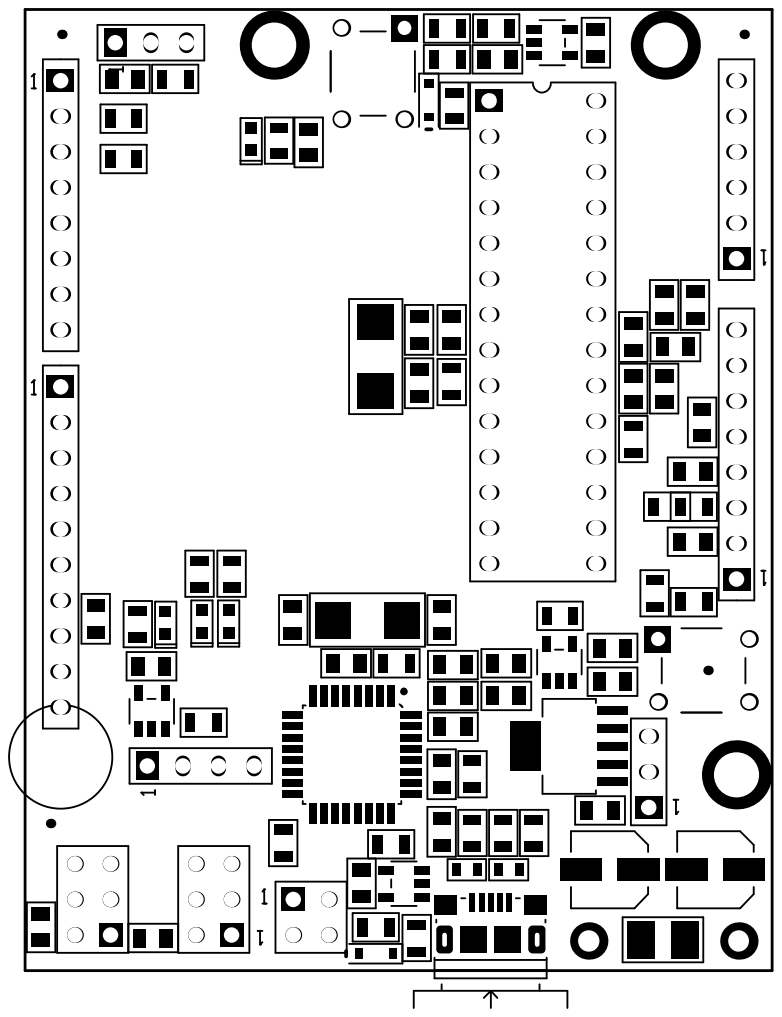
[picture p25: page 1]

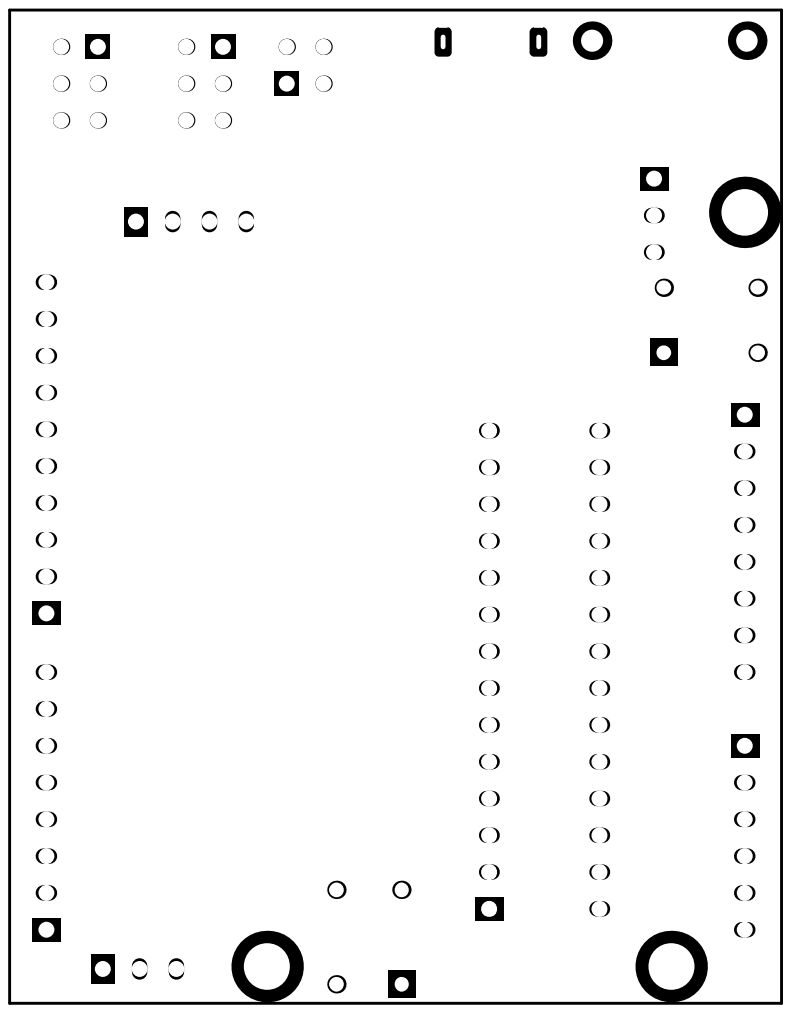
[picture p26: page 2]
