rafagenova/arduino-equivalent-board/(list of files, drawings)

Other design files:
Design Files/V1I1/28Pins_Project_V1I1/28Pins.PcbLib
Design Files/V1I1/28Pins_Project_V1I1/28Pins.SchLib
Design Files/V1I1/28Pins_Project_V1I1/28Pins_Project_V1I1 Project.SchDoc
Design Files/V1I1/28Pins_Project_V1I1/28Pins_Project_V1I1.PrjPcb
Design Files/V1I1/28Pins_Project_V1I1/[01] - COVER PAGE.SchDoc
Design Files/V1I1/28Pins_Project_V1I1/[02] - BLOCK DIAGRAM.SchDoc
Design Files/V1I1/28Pins_Project_V1I1/[03] - 28PINS SCHEMATIC.SchDoc
Design Files/V1I1/28Pins_Project_V1I1/[03] - 28Pins_Schematic.SchDoc
Design Files/V1I1/28Pins_Project_V1I1/[04] - REVISION HISTORY.SchDoc
Document Files/Templates/Schematic/28Pins_Project_V1I1 Project.SchDoc
Document Files/Templates/Schematic/[01] - COVER PAGE.SchDoc
Document Files/Templates/Schematic/[02] - BLOCK DIAGRAM.SchDoc
Document Files/Templates/Schematic/[04] - REVISION HISTORY.SchDoc
